simonyiszk/mosogep-sch-reboot/HW/schematic.pdf

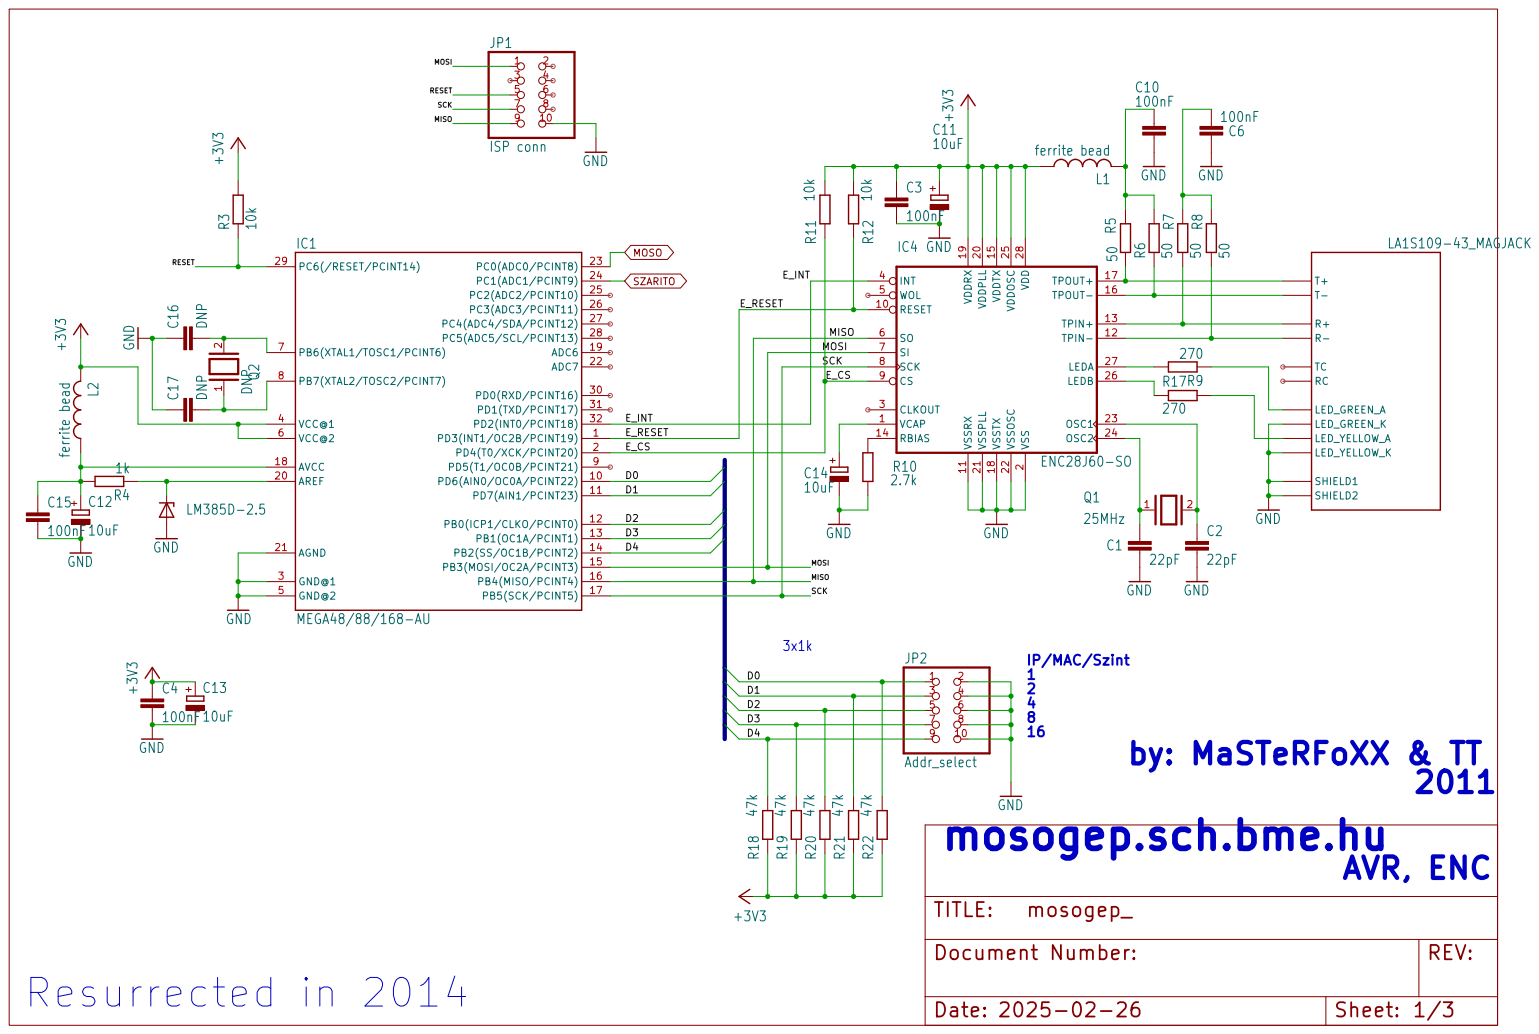
[picture p1: page 2]

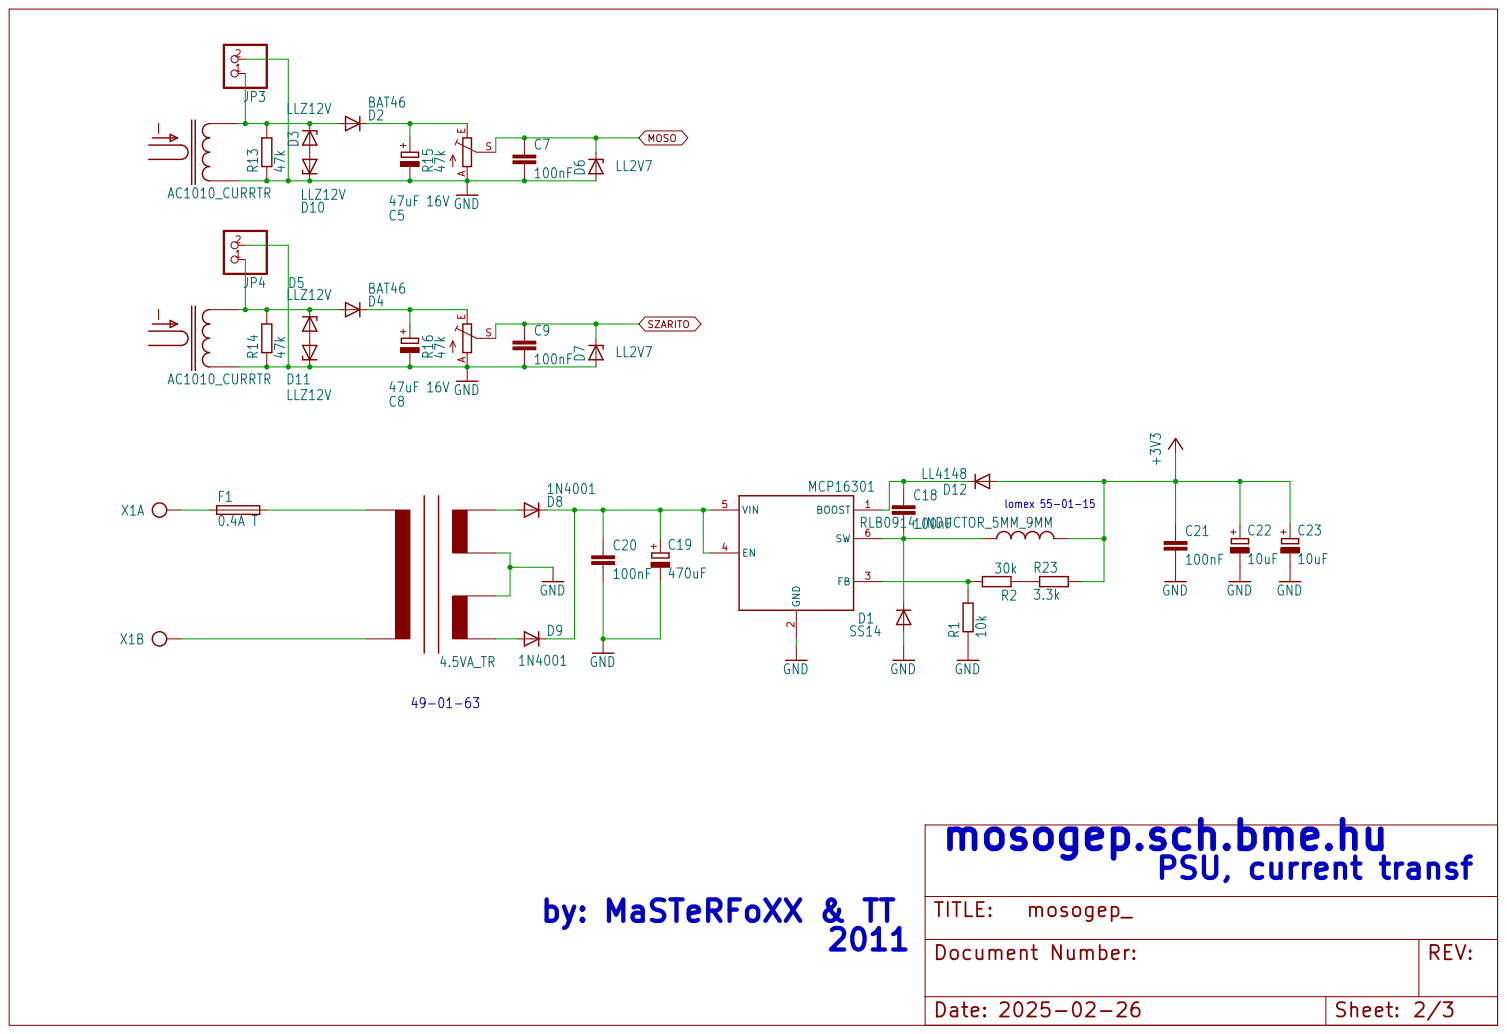
[picture p2: page 3]
