simonyiszk/mosogep-sch-reboot/HW/mosogep_.kicad_pcb

## KiCad design HW/mosogep_.kicad_pcb (2025-01-24)

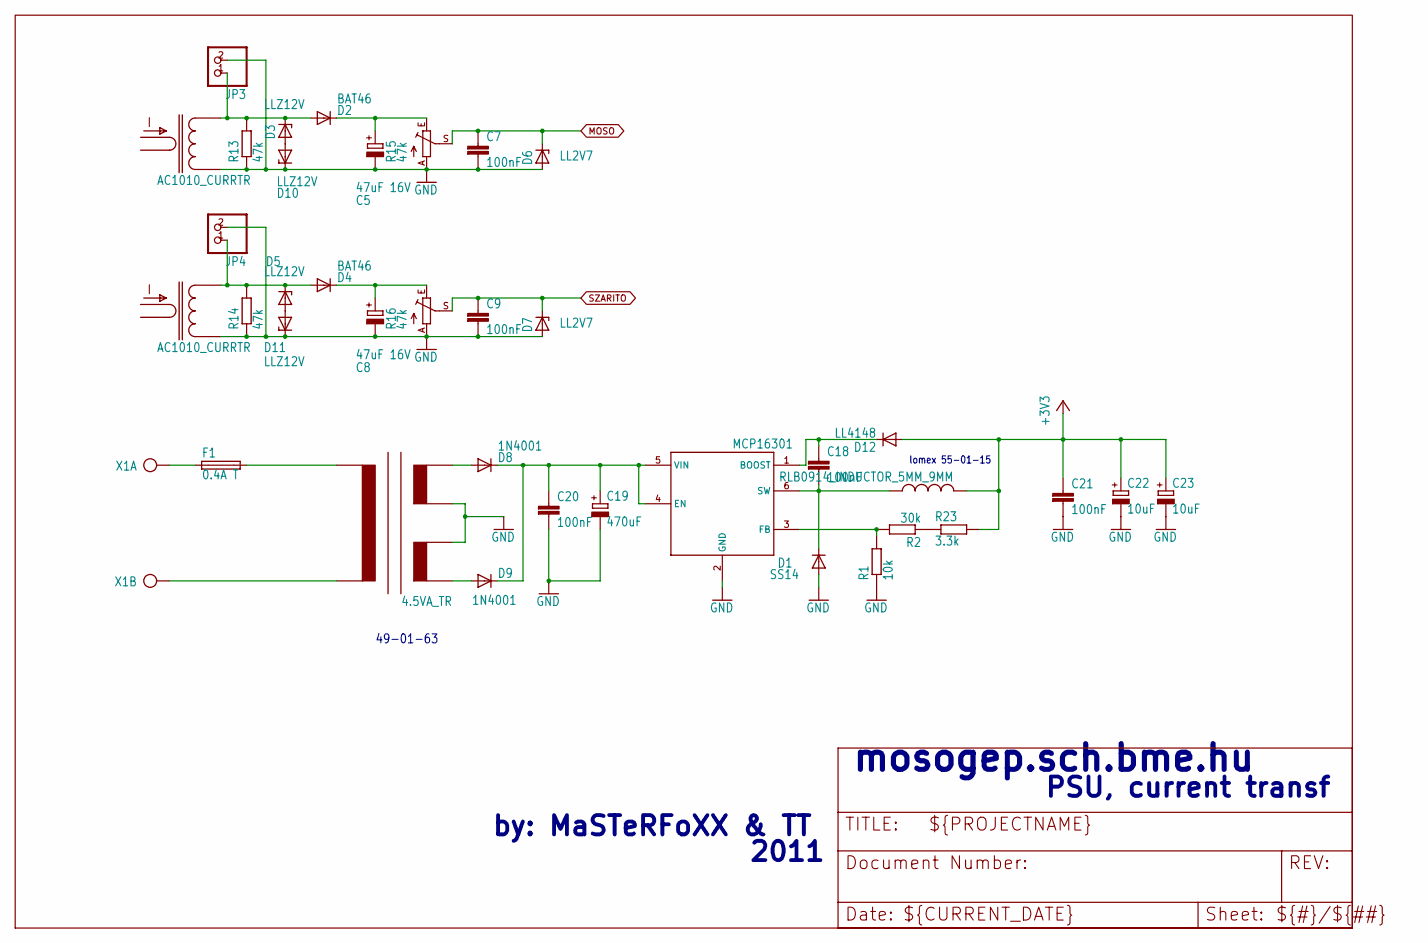
[picture p3: schematic mosogep__2.kicad_sch]

Parts:
C5, C8: 47uF 16V; E2,5-5
C7, C9, C18, C20, C21: 100nF; C1206K
C19: 470uF; E5-10,5
C22, C23: 10uF; B_3528-21R
D1: SS14; DO-214AC
D2, D4: BAT46; SOD80C
D3, D5, D10, D11: LLZ12V; SOD80C
D6, D7: LL2V7; SOD80C
D8, D9: 1N4001; D-7.5
D12: LL4148; SOD80C
F1: 0.4A T; SH22,5A
IC2: MCP16301; SOT23-6
JP3, JP4: PINHD-1X2; 1X02
L3: RLB0914_INDUCTOR_5MM_9MM; L_5MM
R1: 10k; R1206
R2: 30k; R1206
R13, R14: 47k; M1206
R15, R16: 47k; RJ9W
R23: 3.3k; R1206
TR1: 4.5VA_TR; TR4.5VA
TR1_MOSOGEP0, TR2_SZARITO0: AC1010_CURRTR; CURRTR_TALEMA
X1: AK500/2; AK500_2

Connections:
+3V3: C21.1, C22.+, C23.+, D12.A, L3.P$2 (2), R23.2; also elsewhere on the board
GND: C5.-, C7.2, C8.-, C9.2, C19.-, C20.2, C21.2, C22.-, C23.-, D1.A, D6.A, D7.A, D10.C, D11.C, IC2.2 (GND), JP3.2, JP4.2, R1.1, R13.1, R14.1, R15.A, R16.A, TR1.SA_2, TR1.SB1 (SB_1), TR1_MOSOGEP0.2, TR2_SZARITO0.2; also elsewhere on the board
MOSO: C7.1, D6.C, R15.S; also elsewhere on the board
unnamed: D4.A, D5.C, JP4.1, R14.2, TR2_SZARITO0.1
unnamed: C18.2, D1.C, IC2.6 (SW), L3.P$1 (1)
unnamed: D2.A, D3.C, JP3.1, R13.2, TR1_MOSOGEP0.1
unnamed: C18.1, D12.C, IC2.1 (BOOST)
unnamed: C5.+, D2.C, R15.E
unnamed: D3.A, D10.A
unnamed: R2.1, R23.1
unnamed: F1.1, X1.1
unnamed: C8.+, D4.C, R16.E
unnamed: TR1.PR2 (PRI2), X1.2
unnamed: F1.2, TR1.PR1 (PRI1)
unnamed: D8.A, TR1.SA_1
unnamed: D9.A, TR1.SB2 (SB_2)
unnamed: D5.A, D11.A
unnamed: C19.+, C20.1, D8.C, D9.C, IC2.4 (EN), IC2.5 (VIN)
SZARITO: C9.1, D7.C, R16.S; also elsewhere on the board
VREF: IC2.3 (FB), R1.2, R2.2

Notes on the sheet:
mosogep.sch.bme.hu
lomex 55-01-15
PSU, current transf
by: MaSTeRFoXX & TT
2011
49-01-63

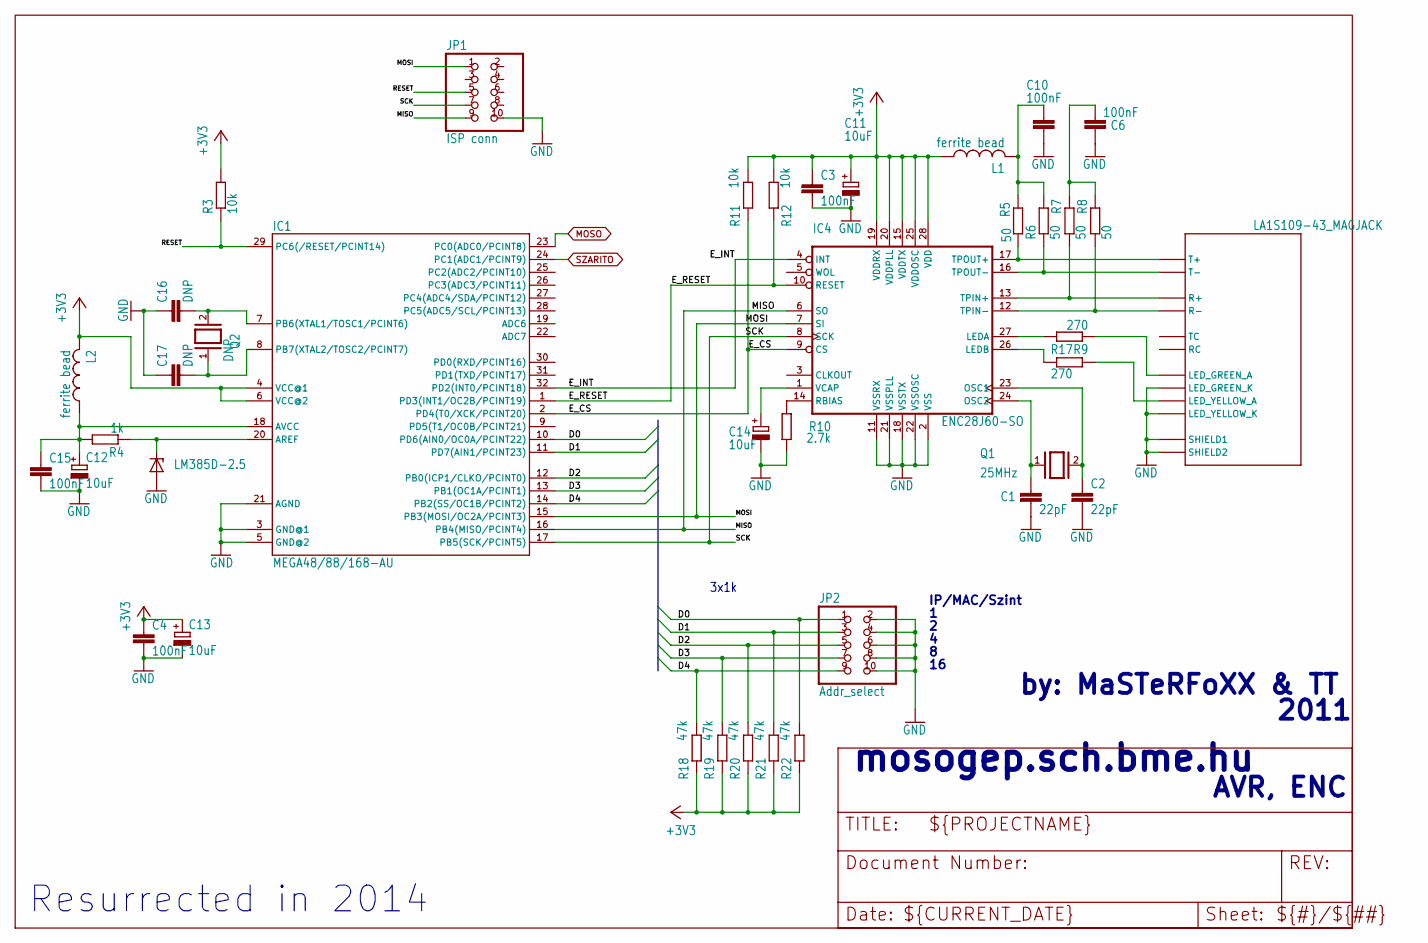
[picture p4: schematic mosogep__1.kicad_sch]

Parts:
C1, C2: 22pF; C1206K
C3, C4, C6, C10, C15: 100nF; C1206K
C11, C12, C13, C14: 10uF; B_3528-21R
C16, C17: DNP; C1206K
CN1: LA1S109-43_MAGJACK; LA1S109_MAGJACK
IC1: MEGA48/88/168-AU; TQFP32-08
IC3: LM385D-2.5; SO08
IC4: ENC28J60-SO; SO28W
JP1: ISP conn; 2X05
JP2: Addr_select; 2X05
L1, L2: ferrite bead; L3225M
Q1: 25MHz; QS
Q2: DNP; QS
R3, R11, R12: 10k; M1206
R4: 1k; M1206
R5, R6, R7, R8: 50; M1206
R9, R17: 270; M1206
R10: 2.7k; M1206
R18, R19, R20, R21, R22: 47k; M1206

Connections:
+3V3: C3.1, C4.1, C11.+, C13.+, IC1.4 (VCC@1), IC1.6 (VCC@2), IC4.15 (VDDTX), IC4.19 (VDDRX), IC4.20 (VDDPLL), IC4.25 (VDDOSC), IC4.28 (VDD), L1.1, L2.2, R3.2, R11.2, R12.2, R18.1, R19.1, R20.1, R21.1, R22.1; also elsewhere on the board
AREF: IC1.20 (AREF), IC3.8 (C), R4.1
D0: IC1.10 (PD6(AIN0/OC0A/PCINT22)), JP2.1, R22.2
D1: IC1.11 (PD7(AIN1/PCINT23)), JP2.3, R21.2
D2: IC1.12 (PB0(ICP1/CLKO/PCINT0)), JP2.5, R20.2
D3: IC1.13 (PB1(OC1A/PCINT1)), JP2.7, R19.2
D4: IC1.14 (PB2(SS/OC1B/PCINT2)), JP2.9, R18.2
E_CS: IC1.2 (PD4(T0/XCK/PCINT20)), IC4.9 (CS), R11.1
E_INT: IC1.32 (PD2(INT0/PCINT18)), IC4.4 (INT)
E_RESET: IC1.1 (PD3(INT1/OC2B/PCINT19)), IC4.10 (RESET), R12.1
GND: C1.2, C2.2, C3.2, C4.2, C6.1, C10.2, C11.-, C12.-, C13.-, C14.-, C15.2, C16.1, C17.1, CN1.GREEN- (LED_GREEN_K), CN1.SHIELD (SHIELD1), CN1.SHIELD2, CN1.YELLOW- (LED_YELLOW_K), IC1.3 (GND@1), IC1.5 (GND@2), IC1.21 (AGND), IC3.4 (A), IC4.2 (VSS), IC4.11 (VSSRX), IC4.18 (VSSTX), IC4.21 (VSSPLL), IC4.22 (VSSOSC), JP1.10, JP2.2, JP2.4, JP2.6, JP2.8, JP2.10, R10.1; also elsewhere on the board
MISO: IC1.16 (PB4(MISO/PCINT4)), IC4.6 (SO), JP1.9
MOSI: IC1.15 (PB3(MOSI/OC2A/PCINT3)), IC4.7 (SI), JP1.1
MOSO: IC1.23 (PC0(ADC0/PCINT8)); also elsewhere on the board
unnamed: IC4.27 (LEDA), R9.2
unnamed: C12.+, C15.1, IC1.18 (AVCC), L2.1, R4.2
unnamed: C1.1, IC4.24 (OSC2), Q1.1
unnamed: C2.1, IC4.23 (OSC1), Q1.2
unnamed: CN1.P$1 (T+), IC4.17 (TPOUT+), R5.2
unnamed: CN1.P$2 (T-), IC4.16 (TPOUT-), R6.1
unnamed: CN1.P$3 (R+), IC4.13 (TPIN+), R7.1
unnamed: CN1.P$4 (R-), IC4.12 (TPIN-), R8.1
unnamed: C10.1, L1.2, R5.1, R6.2
unnamed: C6.2, R7.2, R8.2
unnamed: IC4.14 (RBIAS), R10.2
unnamed: C14.+, IC4.1 (VCAP)
unnamed: CN1.GREEN+ (LED_GREEN_A), R9.1
unnamed: CN1.YELLO+ (LED_YELLOW_A), R17.2
unnamed: IC4.26 (LEDB), R17.1
unnamed: C16.2, IC1.7 (PB6(XTAL1/TOSC1/PCINT6)), Q2.2
unnamed: C17.2, IC1.8 (PB7(XTAL2/TOSC2/PCINT7)), Q2.1
RESET: IC1.29 (PC6(/RESET/PCINT14)), JP1.5, R3.1
SCK: IC1.17 (PB5(SCK/PCINT5)), IC4.8 (SCK), JP1.7
SZARITO: IC1.24 (PC1(ADC1/PCINT9)); also elsewhere on the board

Notes on the sheet:
by: MaSTeRFoXX & TT
3x1k
2011
AVR, ENC
mosogep.sch.bme.hu
Resurrected in 2014~{}
IP/MAC/Szint

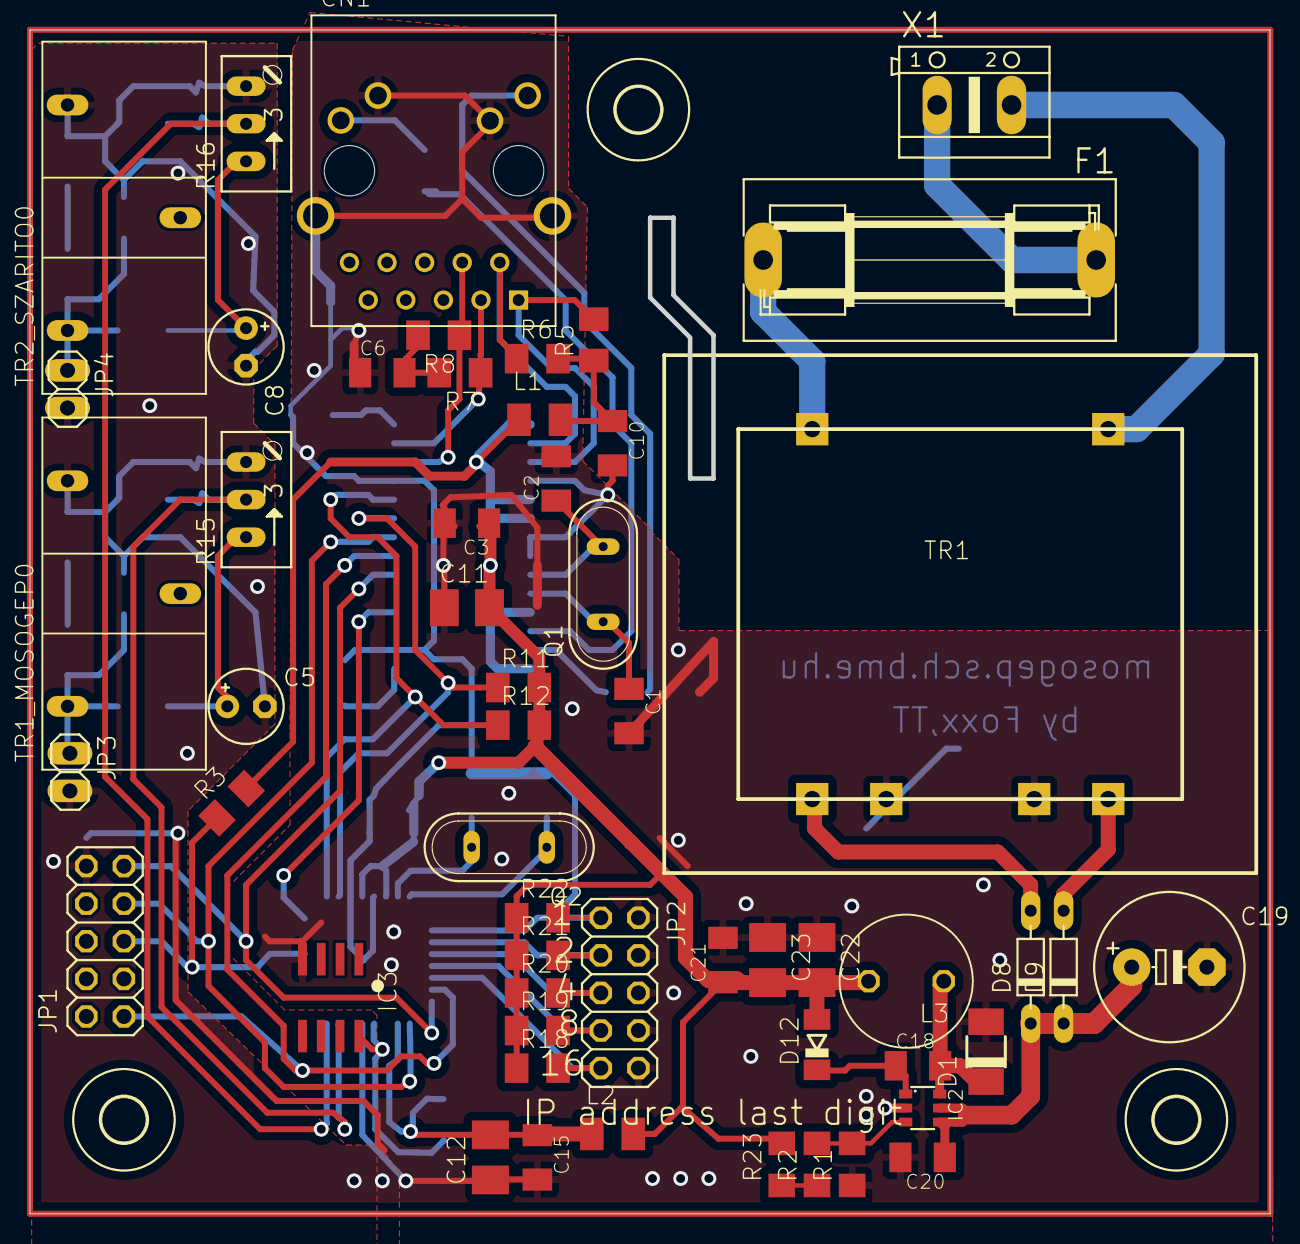
[picture p5: board mosogep_.kicad_pcb from above]

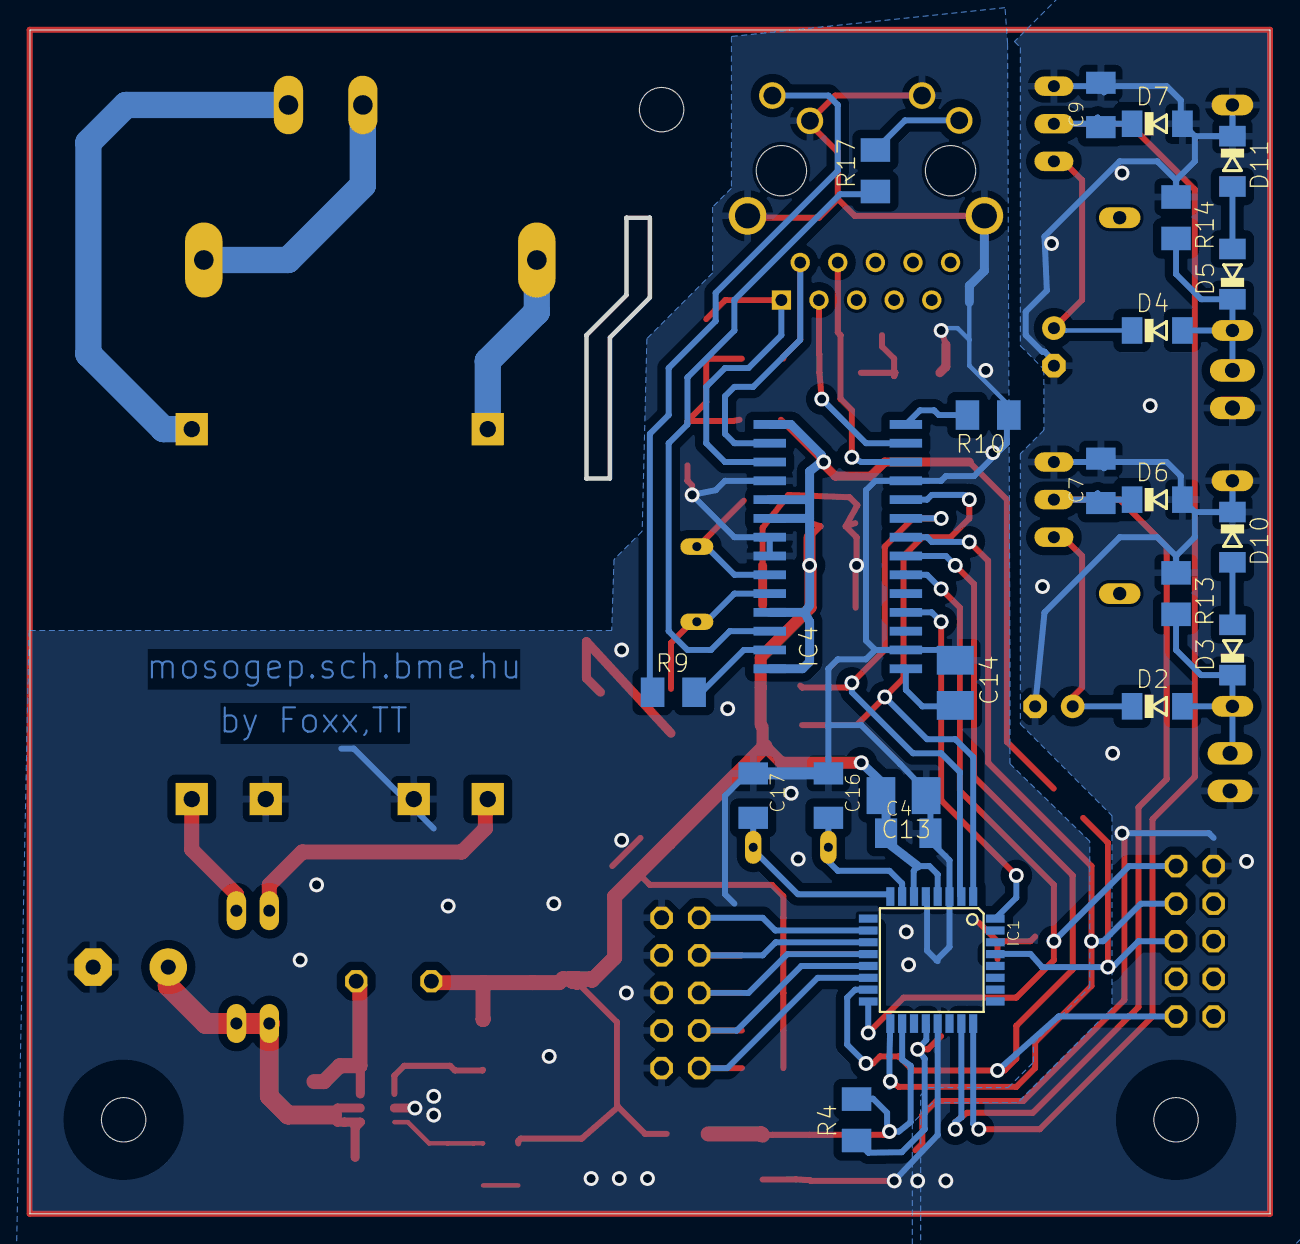
[picture p6: board mosogep_.kicad_pcb from below]

Board: 2 copper layers, 83.8 x 80.0 mm, 80 parts (23 on the bottom side), 50 nets.

Other parts of the board:
U$1, U$2, U$4: 3,0
