simonyiszk/mosogep-sch-reboot/(commit log)

2025-01-24 HW feltöltése
    Kicad konverzió by Turi Marci
    [mosogep_.kicad_pcb, mosogep_.kicad_sch, mosogep__1.kicad_sch, mosogep__2.kicad_sch]
2025-01-24 Exportált PDF-ek törlése
    Schematic hibás volt, a másik kettő nem jól használható
2025-01-24 Driver fix: processzor órajel clash
    8 megára volt fixen állítva, pedig egyébként a kristály le van osztva
    A valódi órajel 1 mega, és amúgy is jobb ötlet a makefileban állítani.
    [enc28j60.c]
2025-01-24 Fix deprecation warnings
    prog_char* -> PGM_P
    [ip_arp_udp_tcp.c, ip_arp_udp_tcp.h]
2025-01-24 Add basic debugging over UART
    From https://github.com/ptrks/avr-usart-printf
2025-01-24 Fix uart build warnings
    [uart.c, uart.h]
2025-01-24 Delay fixálása
    Nem használt busy wait loop törlése, stdlibes verzió haználata
    [mosogep_probalkozas.c]
2025-01-24 Jumper beolvasás javítása
    A PB2 = SPI SS láb hülyén viselkedik,
    ezért a korábbi paneleken ki volt kapcsolva,
    és a 16-os bitet nem lehetett állítani
    Ezt SW-ből fixáltam
    [mosogep_probalkozas.c]
2025-01-24 DEBUG LED átalakítása
    PC0-án nem volt led soha, PC2-re viszont könnyen felrakható egy
2025-01-24 Add fuses and flashing them
2025-02-26 Upload PDF schematic
